DanielaCanasU/SafeRun_Tracker/(list of files, drawings)

Other design files:
PCB/esquematicoInforme.pdsprj
PCB/PCBHELTEC CORREDOR.pdsprj
PCB/PCBHELTEC LOCAL.pdsprj
