DanielaCanasU/SafeRun_Tracker/CODIGOS/ESP32/LOCAL_SAFERUN_ESP32/src/SX1262_Settings.h

/*******************************************************************************************************
  Programs for Arduino - Copyright of the author Stuart Robinson - 02/03/20

  This program is supplied as is, it is up to the user of the program to decide if the program is
  suitable for the intended purpose and free from errors.
*******************************************************************************************************/

//*******  Setup hardware pin definitions here ! ***************

//These are the pin definitions for one of my own boards, the Easy Pro Mini,
//be sure to change the definitions to match your own setup. Some pins such as DIO2,
//DIO3, BUZZER are not used by this sketch so they do not need to be connected and
//should be set to -1.

                             //busy pin on LoRa device 
#define DIO1 4                                 //DIO1 pin on LoRa device, used for RX and TX done 
#define DIO2 -1                                 //DIO2 pin on LoRa device, normally not used so set to -1 
#define DIO3 -1                                 //DIO3 pin on LoRa device, normally not used so set to -1
#define RX_EN 15                                //pin for RX enable, used on some SX126X devices, set to -1 if not used
#define TX_EN 2                                //pin for TX enable, used on some SX126X devices, set to -1 if not used 
#define SW -1                                   //SW pin on some Dorji LoRa devices, used to power antenna switch, set to -1 if not used
                                //on board LED, high for on

#define SCK 18                                  //SCK on SPI3
#define MISO 19                                 //MISO on SPI3 
#define MOSI 23                                 //MOSI on SPI3 

#define NSS 5                                   //select pin on LoRa device
#define NRESET 32                               //reset pin on LoRa device
#define RFBUSY 33                            //busy line

#define LED1 36                                 //on board LED, high for on
#define DIO1 4                                 //DIO1 pin on LoRa device, used for RX and TX done 

#define LORA_DEVICE DEVICE_SX1262               //we need to define the device we are using



//*******  Setup LoRa Parameters Here ! ***************

//LoRa Modem Parameters
const uint32_t Frequency = 915000000;           //frequency of transmissions in hertz
const uint32_t Offset = 0;                      //offset frequency for calibration purposes

const uint8_t Bandwidth = LORA_BW_125;          //LoRa bandwidth
const uint8_t SpreadingFactor = LORA_SF12;       //LoRa spreading factor
const uint8_t CodeRate = LORA_CR_4_8;           //LoRa coding rate
const uint8_t Optimisation = LDRO_AUTO;         //low data rate optimisation setting, normally set to auto

//for SX1262, SX1268 power range is +22dBm to -9dBm
//for SX1261, power range is +15dBm t0 -9dBm

const int8_t TXpower = 22;                      //LoRa transmit power in dBm

const uint16_t packet_delay = 1000;             //mS delay between packets
// Heltec ESP32S3 LoRa (V3) SX1262 receiver 
