DanielaCanasU/SafeRun_Tracker/CODIGOS/HELTEC/HeltecTracker/Pins.h

#pragma once
#include <Arduino.h>

// Botones
#define BUTTON_LEFT 4
#define BUTTON_RIGHT 5
#define BUTTON_SELECT 18

// DFPlayer Mini
#define HELTEC_RX2_PIN 6
#define HELTEC_TX2_PIN 7

// Acelerómetro I2C
#define ADXL345_SCL_PIN 46
#define ADXL345_SDA_PIN 45

// GPS (control Vext)
#define VGNSS_CTRL Vext

// Lectura batería
#define VBAT_ADC_PIN 1
