DanielaCanasU/SafeRun_Tracker/CODIGOS/HELTEC/HeltecTrackerLocal/LOCAL_SAFERUN_HELTEC_ARDUINO/LoRaHandler.h

#pragma once
#include "SensorData.h"
#include <SX126XLT.h>
#include "AppState.h"


// External LoRa object declaration
extern SX126XLT LT;

// Function declarations
bool initLoRaHandler();
bool processLoRaMessage(SensorData &data);
void configureSX1262();
void configureSX1262ForDistance(ExerciseDistance distance);
uint8_t getLastPacketInfo(int8_t* rssi, int8_t* snr);
void getPacketStats(uint32_t* packetCount, uint32_t* errorCount);
void printPacketStats();
String getLastPacketString();
void sendACK(const String& remoteDeviceId);


class LoRa {
    private:
        int mensaje;
        unsigned long lastLoraCheck = 0;
    public:
        LoRa();
        void init();
        void checkIncomeMessage();
        void resetReceptionState(); // Método para resetear el estado de recepción
        bool WAITING_LORA = false; // Hacer público para poder resetearlo desde configureSX1262ForDistance
        int lastACKreceived = 0;
        String lastFromID = "";
};
