DanielaCanasU/SafeRun_Tracker/(commit log)

2025-08-12 Cifrado ESP32
2025-08-23 Cambio de ESP32 a Heltec
2025-09-01 Backtrack funcion y mejora pantallas de info
2025-09-04 Version funcional de firebase con prints agregados
2025-09-04 Pantalla de emparejar dispositivos
2025-09-06 Arreglo de menus, no funciona LoRa
    [LOCAL_SAFERUN_HELTEC_ARDUINO.ino, UI.cpp]
2025-09-07 Prueba para LoRa
2025-09-08 Correcion de LoRa y correcion de centrado de menu principal
2025-09-09 Cambios para arreglar dibujo LoRa
    [LOCAL_SAFERUN_HELTEC_ARDUINO.ino, LoRaHandler.cpp, SensorData.cpp, SensorData.h, UI.cpp, UI.h]
2025-09-10 Problema de dibujo pantalla remoto arreglado
    [SensorData.cpp, SensorData.h]
2025-09-13 Mejora de pantallas Ejercicio y emergencia y arreglo de dibujado de gps
    [Display.cpp, GPS.cpp, GPS.h, HeltecTracker.ino]
2025-10-03 Arreglo pantalla de menu backtrack para devolver hacia arriba
    [UI.cpp]
2025-10-14 Capitulo 4 Fase I Tecnicas de comunicacion
2025-10-14 Fase I Diagnostico Tecnicas de comunicacion y tecnicas de deteccion de emergencia
2025-10-15 Listo la parte del SIM800L
2025-10-16 Avance Fase I Diagnostico Deteccion de caida
2025-10-16 Avance Capitulo 4 Fase I Diagnostico Tecnicas de emergencia
2025-10-17 Completo Fase I Diagnostico Deteccion de Caida
2025-10-17 Completo Fase I Diagnostico Deteccion de Caida2
2025-10-17 Fase I Diagnostico GPS y Reproductor de musica
2025-10-17 Fase I Diagnostivo V1 listo
    [Tablas.xlsx]
2025-10-18 Rebuild repo after removing large file
    [Tablas.xlsx]
2025-10-19 Creacion de clases para submodulos
2025-10-19 Color de las tablas, redundancias y graficas
2025-10-22 Funcion a metodo en detector de caida
2025-10-23 Limpieza de lineas
    Solo cambie la parte de DetectorCaida::checkStatus
2025-11-01 Justo despues de pcb
2025-11-04 Mejora modulo de musica
2025-11-08 Codigo para tomar datos de detector de caida
    Los datos y estados del detector de caida se guardan en la ram del heltec y a traves de una direccion ip en el telefono conectado al mismo wifi del heltec, se pueden descargar en formato csv
2025-11-08 Programa para subir musica al MP3
2025-11-09 Arreglo error redibujado pantalla
    [LOCAL_SAFERUN_HELTEC_ARDUINO.ino]
2025-11-13 Limpieza de codigo, funciones a clases y metodos
2025-11-18 Vista de coordenadas en notificacion de emergencia
2025-11-18 Manual de usuario del sistema Safe Run
2025-11-21 Cambio de pines
2025-11-21 Actualizacon de pantalla de emergencia al activarse automaticamente, y no subida de datos si coordenadas no validas
2025-11-21 Error de pantalla monitoreo
    [Accel.cpp]
2025-11-22 Limpieza de trama de LoRa y add el id a donde va y de donde viene
2025-11-30 Cambios que no me acuerdo de que son
2025-12-05 Ultimo commit de la predefensa
2025-12-07 Menu de opciones para la comunicacion
2026-09-13 Ajuste parseo de los datos del gps
